oschwartz10612/Smart-Table/README.md

# Smart-Table

A table that moves in the X axis.
