oschwartz10612/Smart-Table/PCB/control_PCB_v20.brd

## EAGLE design PCB/control_PCB_v20.brd (2020-08-22)

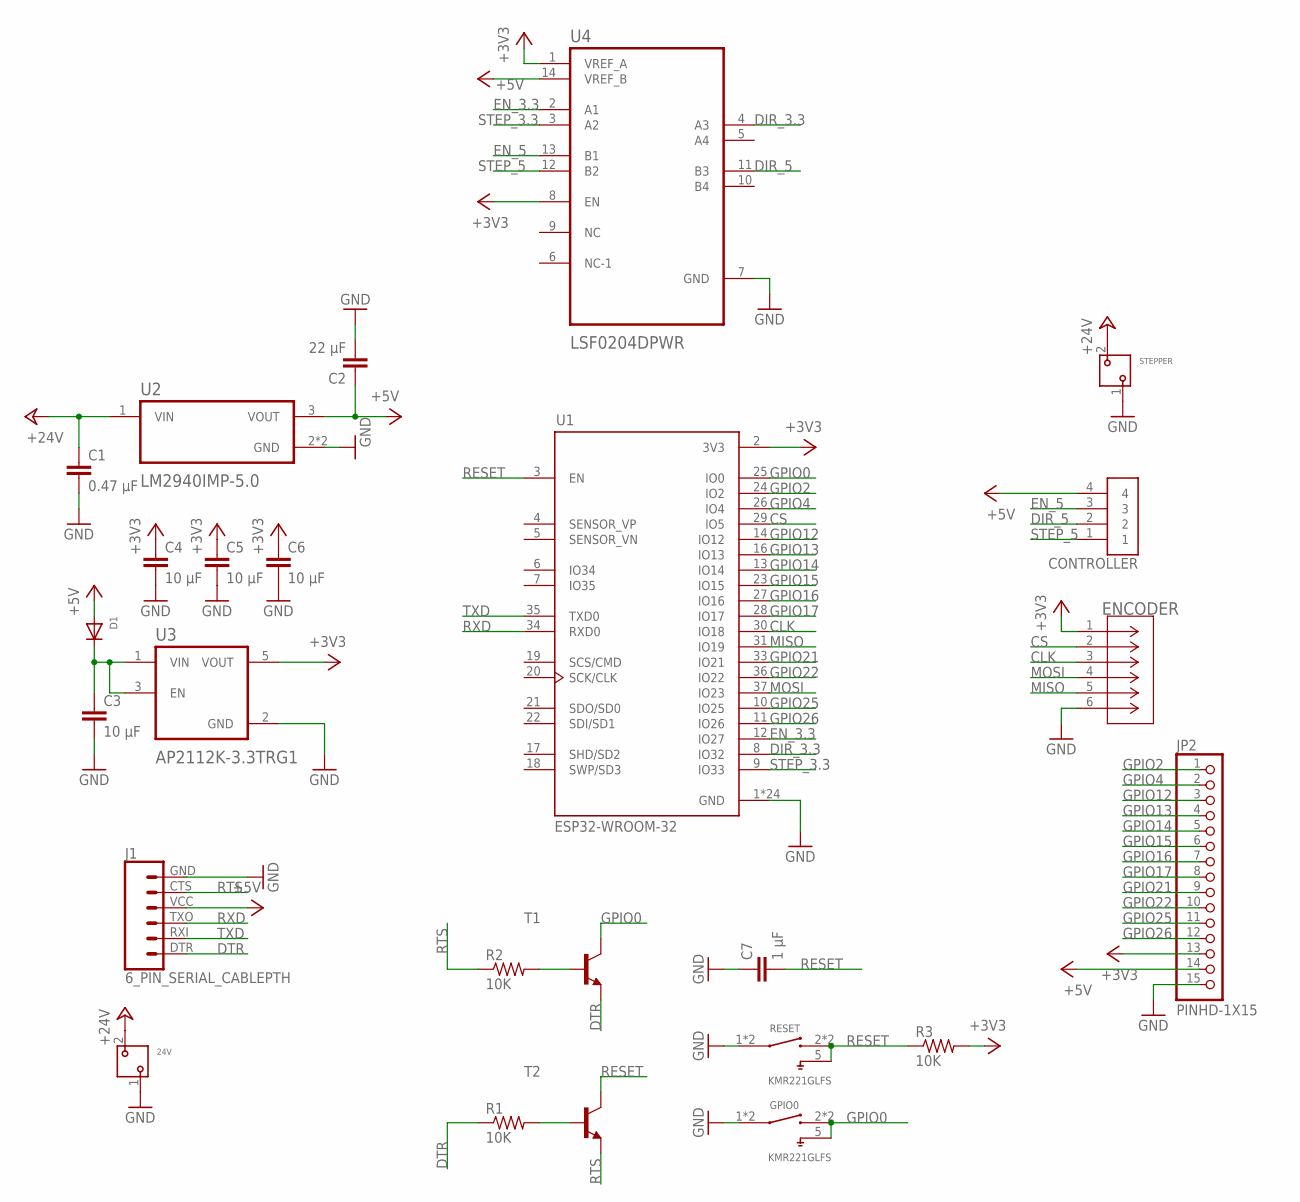
[picture p1: schematic control_v26.sch]

Parts:
24V: 691412320002
C1: 0.47 µF; C0805
C2: 22 µF; C0805
C3, C4, C5, C6: 10 µF; C0805
C7: 1 µF; C0805
CONTROLLER: B4B-XH-A(LF)(SN); JST_B4B-XH-A(LF)(SN)
D1: DIODESOD-123; SOD-123
ENCODER: B6B-XH-A_(LF)(SN); CONN_B6B-XH-A_JST
GPIO0: KMR221GLFS; SW_KMR221GLFS
J1: 6_PIN_SERIAL_CABLEPTH; FTDI_BASIC
JP2: PINHD-1X15; 1X15
R1, R2, R3: 10K; R0805
RESET: KMR221GLFS; SW_KMR221GLFS
STEPPER: 691412320002
T1, T2: MMBT2222ALT1-NPN-SOT23-BEC; SOT23-BEC
U1: ESP32-WROOM-32; MODULE_ESP32-WROOM-32
U2: LM2940IMP-5.0; SOT230P700X180-4N
U3: AP2112K-3.3TRG1; SOT95P285X140-5N
U4: LSF0204DPWR; SOP65P640X120-14N

Connections:
+3V3: C4.1, C5.1, C6.1, ENCODER.1, JP2.13, R3.2, U1.2 (3V3), U3.5 (VOUT), U4.1 (VREF_A), U4.8 (EN)
+5V: C2.1, CONTROLLER.4, D1.A, J1.VCC (4), JP2.14, U2.3 (VOUT), U4.14 (VREF_B)
+24V: 24V.2, C1.1, STEPPER.2, U2.1 (VIN)
CLK: ENCODER.3, U1.30 (IO18)
CS: ENCODER.2, U1.29 (IO5)
DIR_3.3: U1.8 (IO32), U4.4 (A3)
DIR_5: CONTROLLER.2, U4.11 (B3)
DTR: J1.DTR (1), R1.1, T1.E
EN_3.3: U1.12 (IO27), U4.2 (A1)
EN_5: CONTROLLER.3, U4.13 (B1)
GND: 24V.1, C1.2, C2.2, C3.2, C4.2, C5.2, C6.2, C7.1, ENCODER.6, GPIO0.1, GPIO0.4 (1), J1.GND (6), JP2.15, RESET.1, RESET.4 (1), STEPPER.1, U1.1 (GND), U1.15 (GND), U1.38 (GND), U1.39_1 (GND), U1.39_2 (GND), U1.39_3 (GND), U1.39_4 (GND), U1.39_5 (GND), U1.39_6 (GND), U1.39_7 (GND), U1.39_8 (GND), U1.39_9 (GND), U1.39_10 (GND), U1.39_11 (GND), U1.39_12 (GND), U1.39_13 (GND), U1.39_14 (GND), U1.39_15 (GND), U1.39_16 (GND), U1.39_17 (GND), U1.39_18 (GND), U1.39_19 (GND), U1.39_20 (GND), U1.39_21 (GND), U2.2 (GND), U2.4 (GND), U3.2 (GND), U4.7 (GND)
GPIO0: GPIO0.2 (3), GPIO0.3, GPIO0.5, T1.C, U1.25 (IO0)
GPIO2: JP2.1, U1.24 (IO2)
GPIO4: JP2.2, U1.26 (IO4)
GPIO12: JP2.3, U1.14 (IO12)
GPIO13: JP2.4, U1.16 (IO13)
GPIO14: JP2.5, U1.13 (IO14)
GPIO15: JP2.6, U1.23 (IO15)
GPIO16: JP2.7, U1.27 (IO16)
GPIO17: JP2.8, U1.28 (IO17)
GPIO21: JP2.9, U1.33 (IO21)
GPIO22: JP2.10, U1.36 (IO22)
GPIO25: JP2.11, U1.10 (IO25)
GPIO26: JP2.12, U1.11 (IO26)
MISO: ENCODER.5, U1.31 (IO19)
MOSI: ENCODER.4, U1.37 (IO23)
unnamed: C3.1, D1.C, U3.1 (VIN), U3.3 (EN)
unnamed: R1.2, T2.B
unnamed: R2.2, T1.B
RESET: C7.2, R3.1, RESET.2 (3), RESET.3, RESET.5, T2.C, U1.3 (EN)
RTS: J1.CTS (5), R2.1, T2.E
RXD: J1.TXO (3), U1.34 (RXD0)
STEP_3.3: U1.9 (IO33), U4.3 (A2)
STEP_5: CONTROLLER.1, U4.12 (B2)
TXD: J1.RXI (2), U1.35 (TXD0)

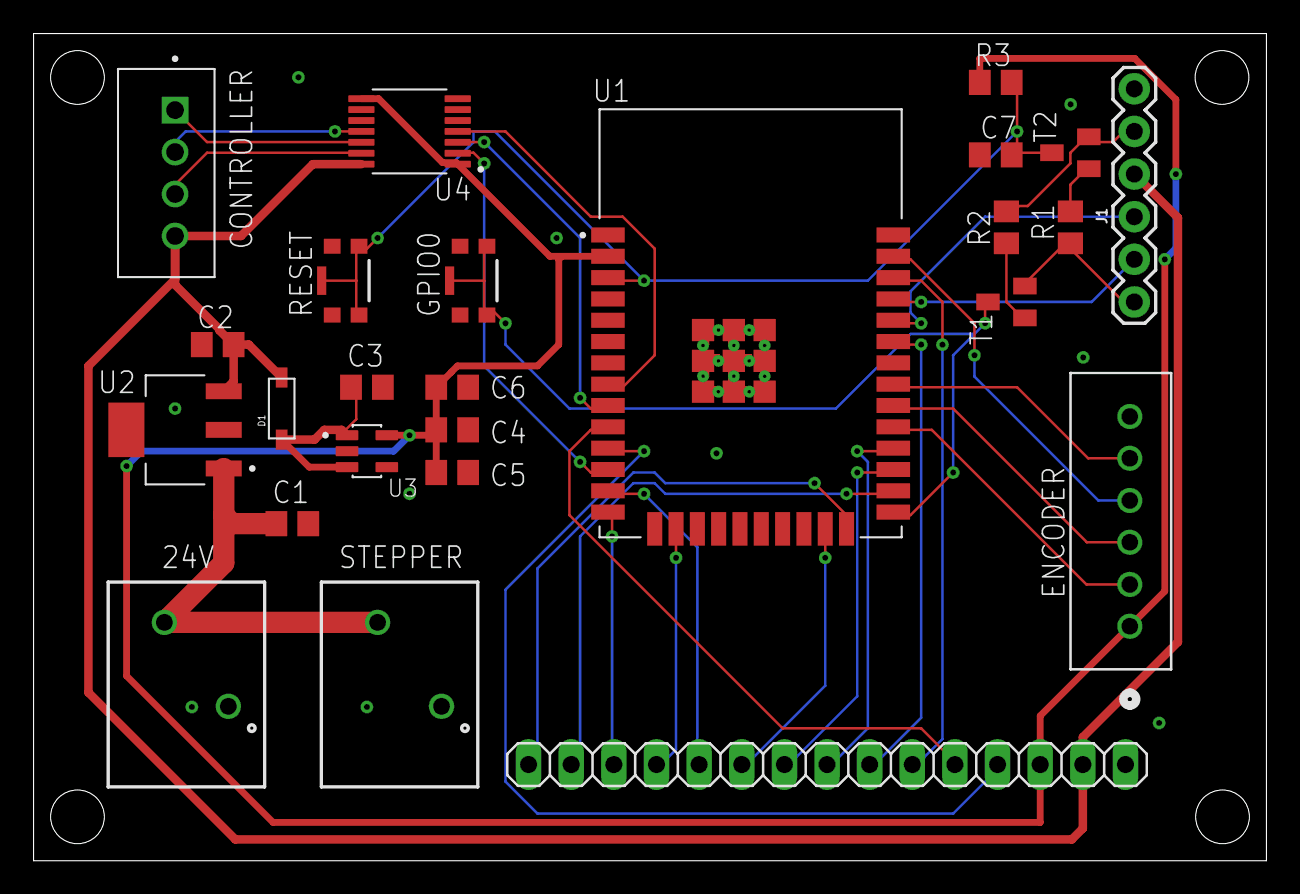
[picture p2: board control_PCB_v20.brd from above]

Board: 2 copper layers, 73.5 x 49.3 mm, 25 parts (0 on the bottom side), 35 nets.
