oschwartz10612/Smart-Table/(commit log)

2020-08-22 Added basic PID
2020-08-22 Clean up pid
2020-08-22 Add PCB
    [control_PCB_v20.brd, control_v26.sch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]
2020-08-23 Added stepper control and mapping
2020-09-02 Added debug, smoothing, velocity
2020-09-03 Stepper abs pos calc by stepper velocuty
2020-09-05 Tranzition to PID
2020-09-06 PID encoder working basic
2020-09-07 Ready for table insertion
2020-09-13 Fix dynaic correction drifting
    [main.cpp]
2020-09-18 AS5048A lib #ifdef DEBUG replacement
    [main.cpp]
2020-09-20 Reset smoothing in setup and enable stepper
    [main.cpp]
2020-10-11 Tweaks - network not working when enabled?
    [main.cpp]
2020-10-19 Initialize motion after network
    Print time difference
2020-10-19 Fixed network issue and tuned activation val
    [main.cpp]
